melonmanchan/Android-Robot-V2/Docs/diagram.png

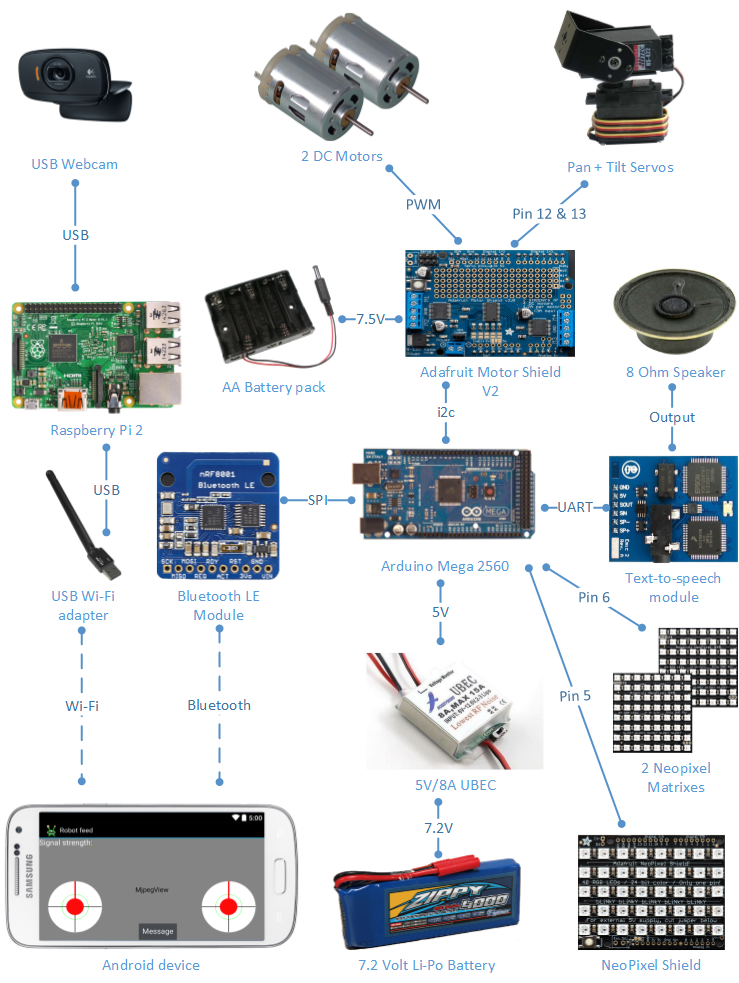
Docs/diagram.png
