melonmanchan/Android-Robot-V2/README.md

Android-Robot-project
=====================

This is my thesis project for JAMK University of Applied Sciences

See video: https://www.youtube.com/watch?v=9J1su0qU4Nk

The finished thesis: http://theseus.fi/handle/10024/97523
