melonmanchan/Android-Robot-V2/Docs/oppari.pptx

## Arduino-robotti

Matti Jokitulppo

## Mikä se on?

- Puhelimen yli ohjattava robotti
- Webbikamera streamaa videota puhelimeen
- Paljon vilkkuvia valoja ja ääniä yms.!

## Opparin taustaa

- Alkuperäinen robotti Pasin Android-kurssille
- Uusi paranneltu versio JAMK:lle markkinointiin, messuille jne.

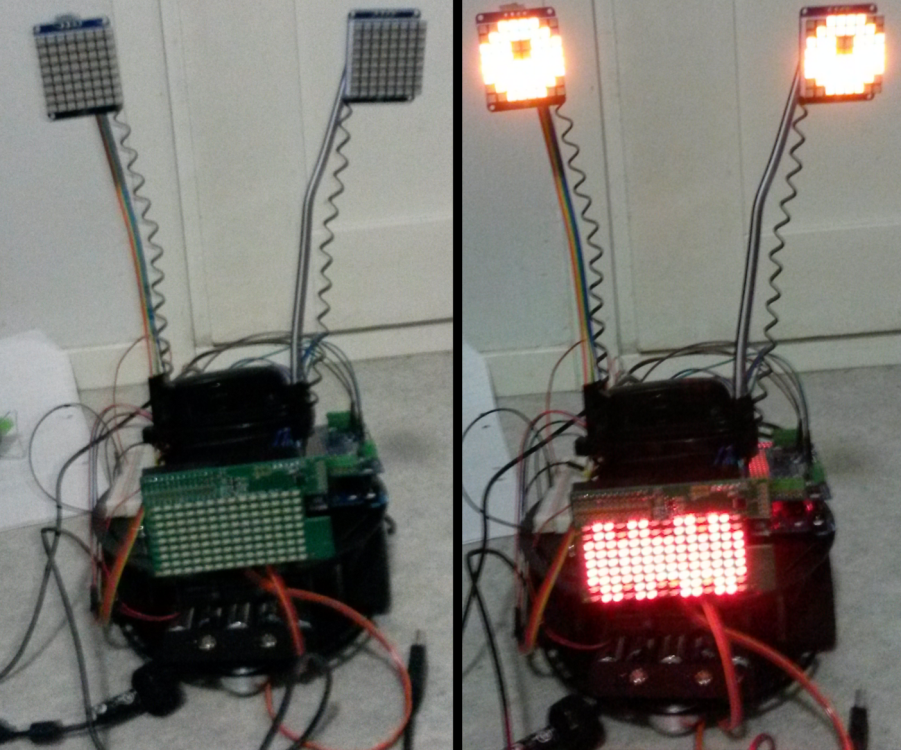
[picture p9: figure]

## Lähtökohdat

- Mobiilisovellusta yksinkertaisemmaksi
- Ns ”teknisiä” ominaisuuksia pois
- Käytettävyys helpommaksi
- Tärkeintä siis helppokäyttöinen ja mielenkiintoinen robotti

## Rakennusprosessi

- Sovelluskehitys vanhan robon pohjalta
- GitHub versionhallintaan
- Suurimmat haasteet itse rakentamisessa
  - Paljon ledejä -> Korkeammat virtavaatimukset
  - Bluetooth Low Energy tavallisen sijaan
  - Fiksummat palikat -> Isommat muistivaatimukset

## Rakennusprosessi II

- Mobiilisovellusta lähdettiin yksinkertaistamaan -> ”turhia” ominaisuuksia pois
- Yleistä ulkoasua siistittiin

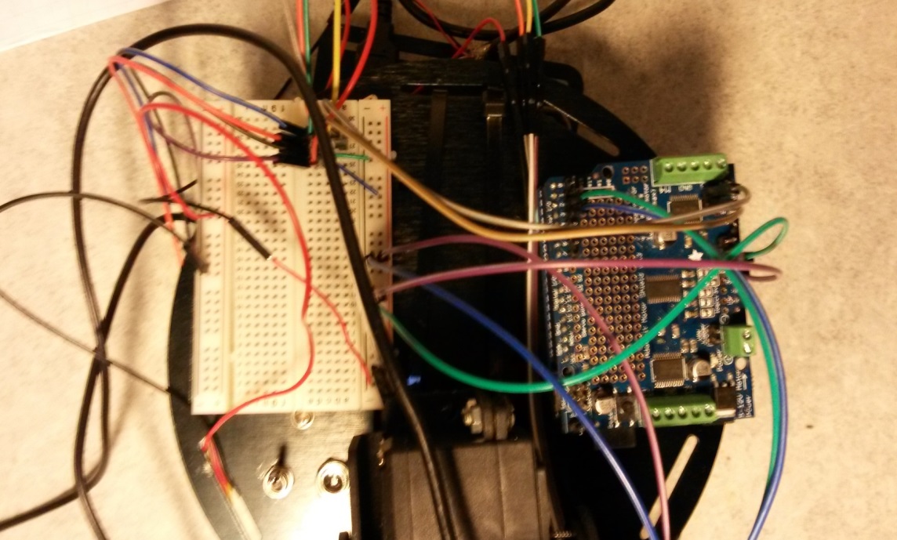
[picture p10: figure]

## Teknologiat

- Robossa Raspberry Pi 2 ja Arduino Mega
- Hallintaan Bluetooth LE sekä Wi-Fi
- Virta LiPo-akusta ja paristoista
- Servoja ja moottoreita
- Ledeinä RBG-NeoPixelit ja audioon EMIC-2

## Teknologiat II

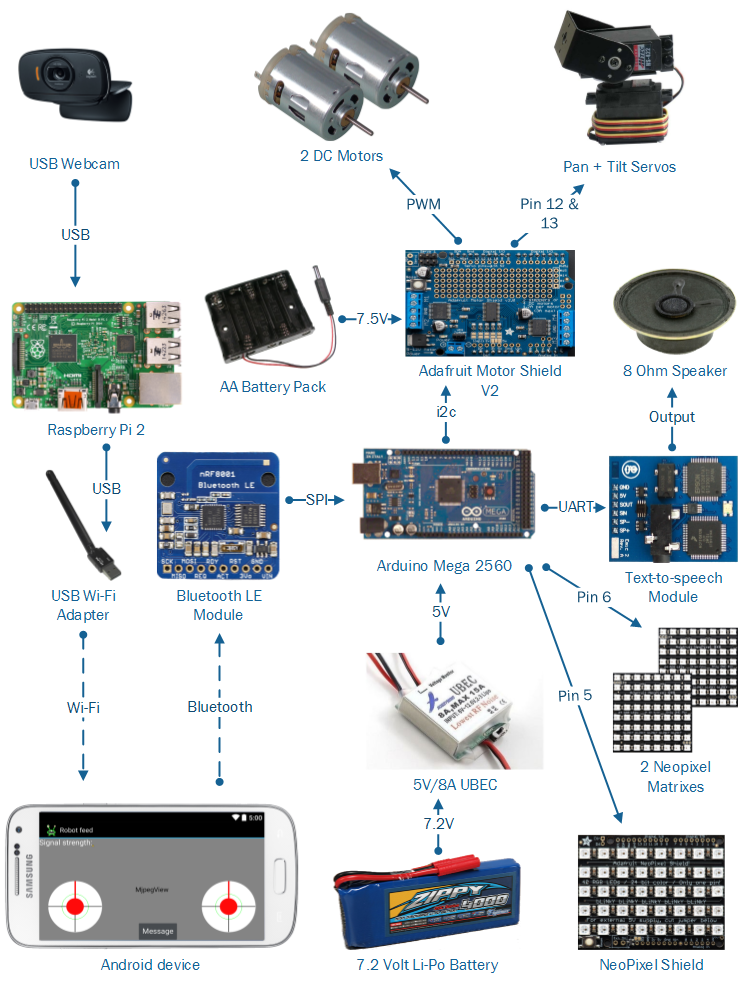
[picture p11: figure]

- Kuvassa aika yksinkertaistettuna robotin kytkennät

## Demo!

## Kehitysideat

- Bluetoothista luopuminen (Pelkkä Wi-Fi Raspin kautta)?
  - Säästää muistia/laskentaa Arduinon puolelta
  - Mahd. ongelmana korkeampi vasteaika
- Mahd. toinen Bluetooth moduuli?
- Web-applikaatio ohjaamiseen?

## Kysymyksiä?

## Kiitos!

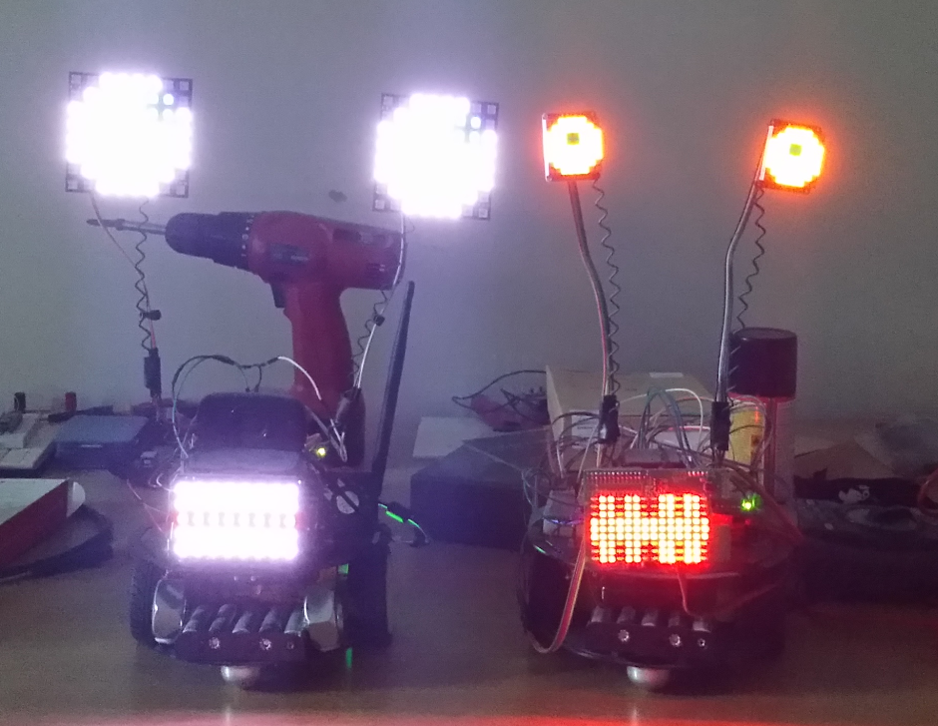
[picture p12: figure]
