melonmanchan/Android-Robot-V2/App/src/com/example/robotapp/Settings.java

package com.example.robotapp;

import java.io.OutputStream;
import java.util.ArrayList;
import java.util.UUID;

import android.support.v7.app.ActionBarActivity;
import android.app.Activity;
import android.app.AlertDialog;
import android.bluetooth.BluetoothAdapter;
import android.bluetooth.BluetoothDevice;
import android.bluetooth.BluetoothSocket;
import android.content.BroadcastReceiver;
import android.content.Context;
import android.content.DialogInterface;
import android.content.Intent;
import android.content.IntentFilter;
import android.content.SharedPreferences;
import android.os.Bundle;
import android.os.SystemClock;
import android.util.Log;
import android.view.Menu;
import android.view.MenuItem;
import android.view.View;
import android.widget.AdapterView;
import android.widget.AdapterView.OnItemClickListener;
import android.widget.ArrayAdapter;
import android.widget.CheckBox;
import android.widget.EditText;
import android.widget.ListView;
import android.widget.Spinner;
import android.widget.TextView;
import android.widget.Toast;

public class Settings extends Activity {

	private final static int REQUEST_ENABLE_BT = 1;
    private static final int REQUEST_SELECT_DEVICE = 2;

	// seems to be a working UUID for the HC-05 Bluetooth module
	private final static UUID APP_UUID = UUID.fromString("00001101-0000-1000-8000-00805F9B34FB");

	private String cameraIPAddress;
	private String cameraPort;
	
	private String[] emotes;
	
	private int movementUpdateSpeed;
	private boolean isCameraEnabled;
	private int selectedVideoSizeSpinnerIndex;
	
	private ApplicationState appState;
	private BluetoothStreamManager btStreamManager;
	private SharedPreferences sharedPref;
	
	TextView updateSpeedTextView;
	TextView cameraIPAddressTextView;
	TextView cameraPortTextView;
	
	TextView cameraHeightTextView;
	TextView cameraWidthTextView;
	
	CheckBox isCameraEnabledCheckBox;
	
	Spinner videoFeedSizeSpinner;
	
	private BluetoothAdapter bluetoothAdapter;

	private ArrayAdapter<CharSequence> spinnerAdapter;
	
    private ArrayList<BluetoothDevice> bluetoothDevices;
    private BluetoothSocket bluetoothSocket;
    private BluetoothDevice deviceInUse;
    
    private OutputStream bluetoothOutput;
    
	@Override
	protected void onCreate(Bundle savedInstanceState) {
		super.onCreate(savedInstanceState);
		setContentView(R.layout.activity_settings);
		appState = (ApplicationState)this.getApplication();
		btStreamManager = appState.getStateManager();
		btStreamManager.setCurrentActivity(this);
		btStreamManager.initializeBluetoothAdapter();
		sharedPref = getApplicationContext().getSharedPreferences("RobotPreferences", 0);
			
		cameraIPAddress = sharedPref.getString("CAMERA_IP_ADDRESS", "127.0.0.1");
		cameraPort = sharedPref.getString("CAMERA_PORT", "8080");
		movementUpdateSpeed = sharedPref.getInt("BT_UPDATE_SPEED", 115);
		isCameraEnabled = sharedPref.getBoolean("IS_CAMERA_ENABLED", true);
		selectedVideoSizeSpinnerIndex = sharedPref.getInt("VIDEO_SIZE_SELECTED_INDEX", 0);
		loadEmotes(sharedPref);
		
		
		cameraIPAddressTextView = (TextView) findViewById(R.id.cameraIPText);
		//cameraPortTextView = (TextView) findViewById(R.id.cameraPortText);
		updateSpeedTextView = (TextView) findViewById(R.id.BTupdateSpeedText);
		isCameraEnabledCheckBox = (CheckBox) findViewById(R.id.isCameraEnabledCheckBox);
		videoFeedSizeSpinner = (Spinner) findViewById(R.id.feedSizeSpinner);
		
		spinnerAdapter = ArrayAdapter.createFromResource(this, R.array.video_size_array, android.R.layout.simple_spinner_dropdown_item);
		
		videoFeedSizeSpinner.setAdapter(spinnerAdapter);
		
		cameraIPAddressTextView.setText(cameraIPAddress);
		//cameraPortTextView.setText(String.valueOf(cameraPort));
		updateSpeedTextView.setText(String.valueOf(movementUpdateSpeed));
		isCameraEnabledCheckBox.setChecked(isCameraEnabled);
		videoFeedSizeSpinner.setSelection(selectedVideoSizeSpinnerIndex);
		
		bluetoothDevices = new ArrayList<BluetoothDevice>();
		initiateBluetooth();		
		
	}

	@Override
	protected void onResume(){
		super.onResume();
		System.out.println("changed activity");
		btStreamManager.setCurrentActivity(this);
	}
	
	protected void onStop() {
		super.onStop();
		
		SharedPreferences.Editor editor = sharedPref.edit();
		
		editor.putString("CAMERA_IP_ADDRESS", cameraIPAddressTextView.getText().toString());
		//editor.putString("CAMERA_PORT", cameraPortTextView.getText().toString());
		editor.putInt("BT_UPDATE_SPEED", Integer.parseInt(updateSpeedTextView.getText().toString()));
		editor.putBoolean("IS_CAMERA_ENABLED", isCameraEnabledCheckBox.isChecked());
		editor.putInt("VIDEO_SIZE_SELECTED_INDEX", videoFeedSizeSpinner.getSelectedItemPosition());
		// ????
		
		String[] videoSize = videoFeedSizeSpinner.getSelectedItem().toString().split("x");
		com.camera.simplemjpeg.MjpegView.setImageSize(Integer.parseInt(videoSize[0]),  Integer.parseInt(videoSize[1]));
		saveEmotes(editor);

		editor.commit();
		
	}
	
	
	@Override
	public boolean onCreateOptionsMenu(Menu menu) {
		// Inflate the menu; this adds items to the action bar if it is present.
		getMenuInflater().inflate(R.menu.settings, menu);
		return true;
	}

	@Override
	public boolean onOptionsItemSelected(MenuItem item) {
		// Handle action bar item clicks here. The action bar will
		// automatically handle clicks on the Home/Up button, so long
		// as you specify a parent activity in AndroidManifest.xml.
		int id = item.getItemId();
		if (id == R.id.action_settings) {
			return true;
		}
		return super.onOptionsItemSelected(item);
	}
	
    @Override
    public void onActivityResult(int requestCode, int resultCode, Intent data) {
        switch (requestCode) {

        case REQUEST_SELECT_DEVICE:
        	//When the DeviceListActivity return, with the selected device address
            if (resultCode == Activity.RESULT_OK && data != null) {
                String deviceAddress = data.getStringExtra(BluetoothDevice.EXTRA_DEVICE);
               btStreamManager.connectToDevice(deviceAddress);          
            }
            break;
        case REQUEST_ENABLE_BT:
            // When the request to enable Bluetooth returns
            if (resultCode == Activity.RESULT_OK) {
                Toast.makeText(this, "Bluetooth has turned on ", Toast.LENGTH_SHORT).show();

            } else {
                // User did not enable Bluetooth or an error occurred
               // Log.d(TAG, "BT not enabled");
                Toast.makeText(this, "Problem in BT Turning ON ", Toast.LENGTH_SHORT).show();
                finish();
            }
            break;
        default:
            break;
        }
    }

    

	public void openEmotePrompt(final View view)
	{
		final EditText messageEditText = new EditText(this);
		String savedMsg = getSavedEmote(view);
		if (savedMsg == null) { 
			savedMsg = "Hello!";
		}
		System.out.println("message:" +savedMsg);
		messageEditText.setText(savedMsg);
		// Build a dialog box to get user input
		new AlertDialog.Builder(this)
	    .setTitle("Set emote")
	    .setMessage("Save an emote hotkey!")
	    .setView(messageEditText)
	    .setPositiveButton("Ok", new DialogInterface.OnClickListener() {
	        public void onClick(DialogInterface dialog, int whichButton) {
	            String value = messageEditText.getText().toString();
	            // regex magic to check for ASCII compliance.
	            if (value.length() < 35)
	            {
		            if (!value.matches("\\p{ASCII}+"))
		            {
		            	Toast.makeText(getApplicationContext(), "ASCII only please!", Toast.LENGTH_LONG).show();
		            }
		            else 
		            {
		            	setSavedEmote(view, value);
		            }
	            }
	            else 
	            {
	            	Toast.makeText(getApplicationContext(), "Message must be under 35 characters!", Toast.LENGTH_LONG).show();
	            }
	            
	        }
	    }).setNegativeButton("Cancel", new DialogInterface.OnClickListener() {
	        public void onClick(DialogInterface dialog, int whichButton) {
	            // Do nothing.
	        	return;
	        }
	    }).show();
	}
 
	public String getSavedEmote(View view) {
    	switch (view.getId()) {
    	case R.id.emoteBtn1:
    		return emotes[0];
    	case R.id.emoteBtn2:
    		return emotes[1];
    	case R.id.emoteBtn3:
    		return emotes[2];

    	case R.id.emoteBtn4:
    		return emotes[3];
    	}
		return "N/A";
	}
	
	 
		public void setSavedEmote(View view, String emote) {
	    	switch (view.getId()) {
	    	case R.id.emoteBtn1:
	    		emotes[0] = emote;
	    		break;
	    	case R.id.emoteBtn2:
	    		emotes[1] = emote;
	    		break;
	    	case R.id.emoteBtn3:
	    		emotes[2] = emote;
	    		break;
	    	case R.id.emoteBtn4:
	    		emotes[3] = emote;
	    		break;
	    	}
		}	
	public void switchToFeed(View view)
	{
		String currentState = btStreamManager.getConnectionState();
		
		if (currentState == "connected")
		{
			Intent intent = new Intent(getApplicationContext(), Feed.class);
			intent.putExtra("BT_UPDATE_SPEED", Integer.parseInt(updateSpeedTextView.getText().toString()));
			intent.putExtra("CAMERA_IP_ADDRESS", cameraIPAddressTextView.getText().toString());
			intent.putExtra("IS_CAMERA_ENABLED", isCameraEnabledCheckBox.isChecked());
			intent.putExtra("EMOTE_ARRAY", emotes);
			
			startActivity(intent);
		}
		else if (currentState == "connecting")
		{
			Toast.makeText(this, "Still connecting! Please wait.", Toast.LENGTH_LONG).show();
		}
		else if (currentState == "disconnected")
		{
			Toast.makeText(this, "Connect to robot before moving on.", Toast.LENGTH_LONG).show();
		}
		
	}
	
	public void checForAvailableBLEDevices(View view)
	{
		
		Intent newIntent = new Intent(this, DeviceListActivity.class);
		startActivityForResult(newIntent, REQUEST_SELECT_DEVICE);

	}
	
	protected void onDestroy() {
		super.onDestroy();
	}	
	
	
	private void initiateBluetooth() {
		try {
			
		System.out.println("Initiating bluetooth...");
	
		bluetoothAdapter = BluetoothAdapter.getDefaultAdapter();
		
		System.out.println("checking if adapter is null...");
		
		if (bluetoothAdapter == null)
		{
			Toast.makeText(this, "Device does not support bluetooth :(", Toast.LENGTH_LONG).show();
			System.exit(0);
		}
		
		System.out.println("checking if adapter is enabled...");

		
		if (!bluetoothAdapter.isEnabled()) {
		    Intent enableBtIntent = new Intent(BluetoothAdapter.ACTION_REQUEST_ENABLE);
		    this.startActivityForResult(enableBtIntent, REQUEST_ENABLE_BT);
		    //Feed.this.startActivityForResult(enableBtIntent, REQUEST_ENABLE_BT);
		}

		}
		catch (Exception ex) {
			System.out.println(ex.getMessage());
		}
		
	}
	
	public void loadEmotes (SharedPreferences shared) {
		emotes = new String[4];
		for (int i = 0; i < 4; i++){
			emotes[i] = shared.getString("emotes" + i, "Hello!");
		}
	}
	
	public void saveEmotes (SharedPreferences.Editor editor) {
		for (int i = 0; i < emotes.length; i++){
			editor.putString("emotes"+ i, emotes[i]);
		}
	}
	
}
