melonmanchan/Android-Robot-V2/(commit log)

2015-03-30 soldered on capacitor fix to robot, so we can run at full speed now without motor shield issues
    [robot.ino]
2015-03-30 changed project settings around so referenced libraries are correct
    [Feed.java]
2015-03-31 screwing around some more with the app settings layout
2015-04-06 removed commented out motor command, upped servo increment since panning and tilting was too slow.
    [Feed.java, robot.ino]
2015-07-23 Add some stuff about the previous prototype
2015-07-23 Fix bug on toast
    [Settings.java]
2015-07-26 Add stuff about power
2015-07-29 Write stuff about the arduino and c++
2015-07-29 Wrote a bit about the Arduino IDE
2015-08-02 start writing about the arduino application
2015-08-04 Write stuff about the arduino boards
2015-08-13 Rewriting the assembly section
2015-08-13 Cleaning up some formatting, more writing on assembly
2015-08-15 Write stuff on the arduino ide
2015-08-15 Add a code sample of writing bluetooth stuff to arduino
2015-08-18 Add table of Arduino pins
2015-08-27 Update powerpointerino
